sai1999gaurav/Institute-Technical-Summer-Project---IITB--2018/ITSP final presentation.pdf

# ITSP

TEAM TGAV

Team Id- 24

3D Hologram with hand gesture control!!

-ANSHUL TOMAR, ANUGOLE SAI GAURAV, ANWESH MOHANTY & VISHWAS BHARTI

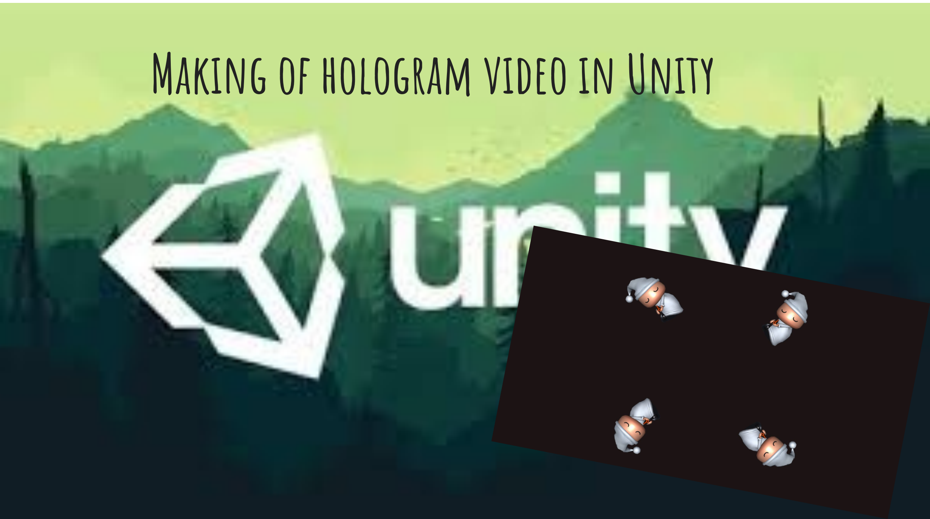
[picture p3: page 2]

Making of hologram video in Unity

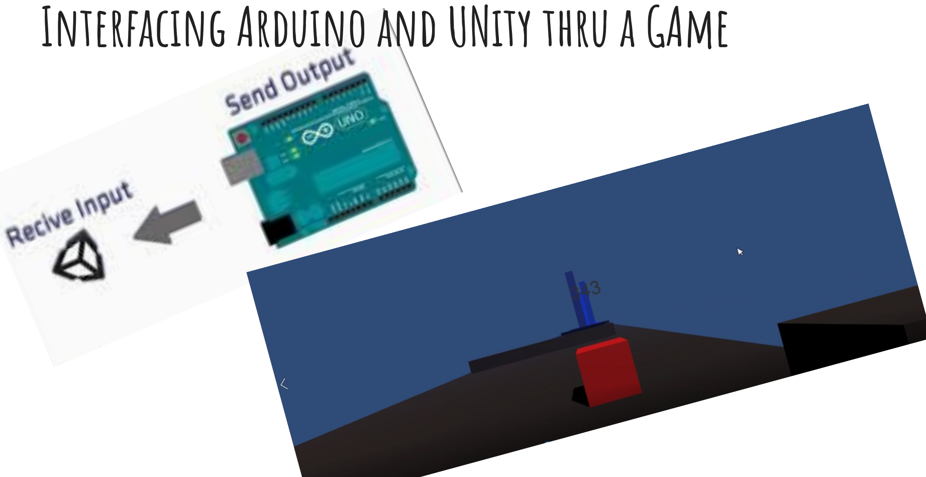
[picture p4: page 3]

Interfacing Arduino and UNity thru a GAme

Making of the pyramid

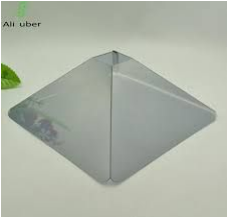
[picture p5: figure]

Sensor board designing and circuit

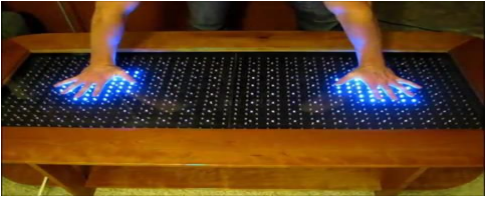
[picture p6: figure]
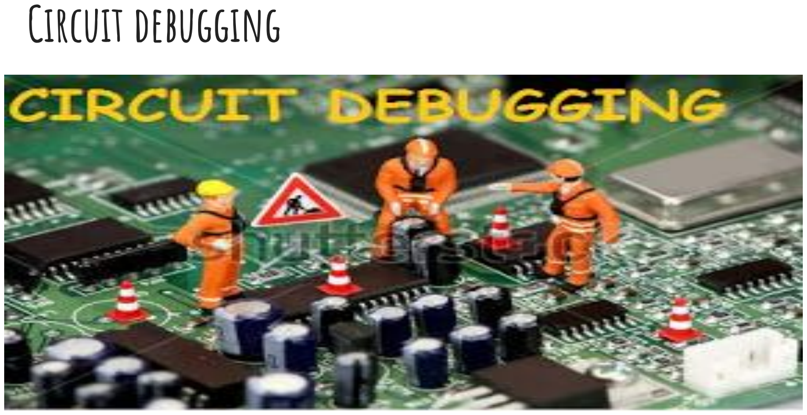
[picture p7: page 6]

Circuit debugging

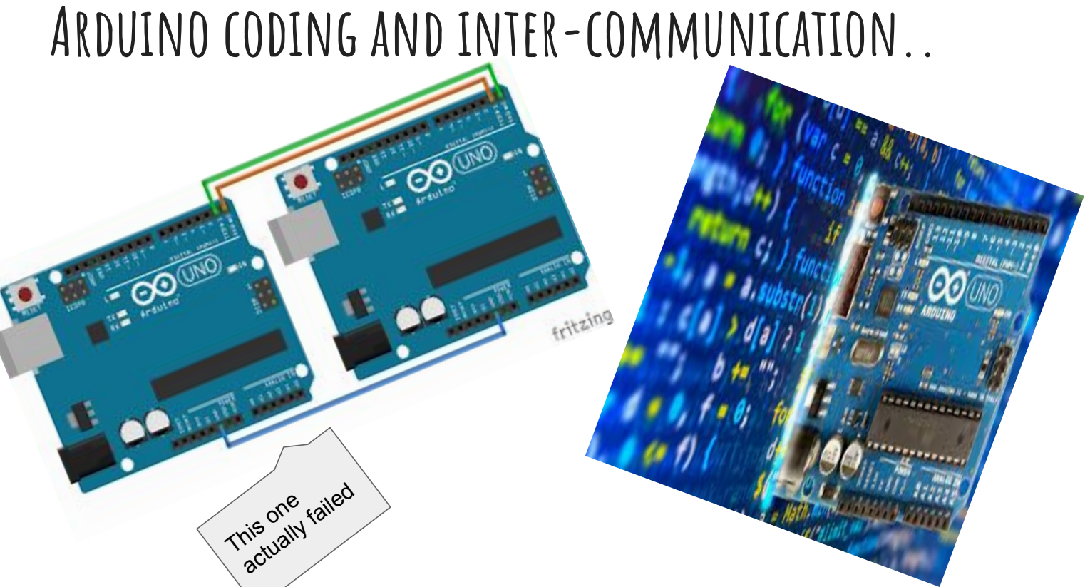
[picture p8: page 7]

Arduino coding and inter-communication..

This one

actually failed

Solution: Arduino mega!!

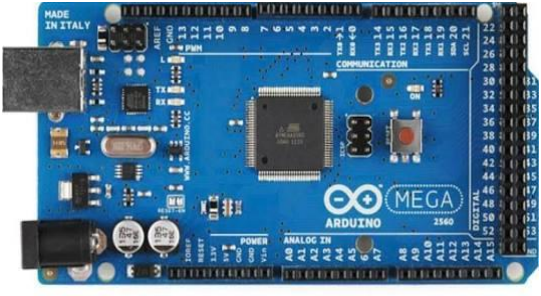
[picture p9: figure]

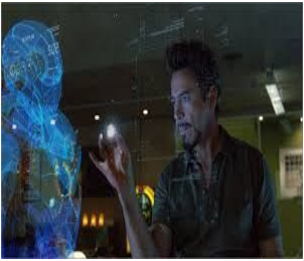
[picture p10: figure]

Finally...

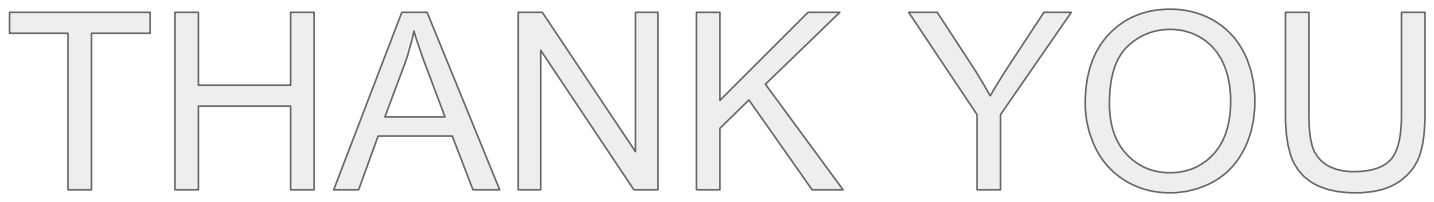
[picture p11: page 10]
